SamanthaTriana/DERMATEC_tg/Anexo F_diseño_housing/Anexo F_ Housing_del_sistema_embebido.pdf

Anexo F: Housing del sistema embebido

Las tres versiones se desarrollaron progresivamente, incorporando

retroalimentación de pruebas funcionales y consideraciones de manufactura:

- Versión 1: Diseño inicial con geometría simple, enfoque en contención básica

de componentes.

Figura 1.

Ensamble del housing de la primera versión e impresión 3D del prototipo.

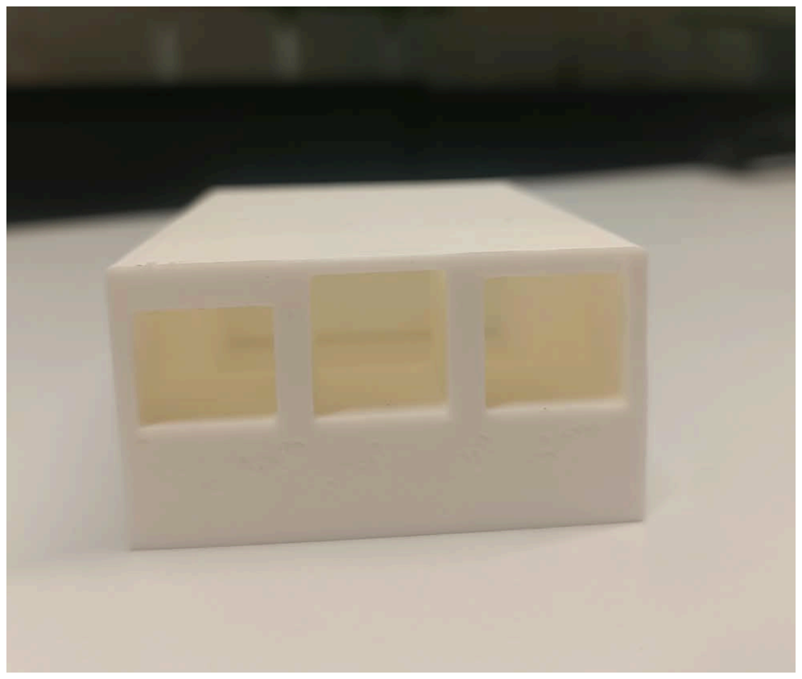
[picture p1: figure]
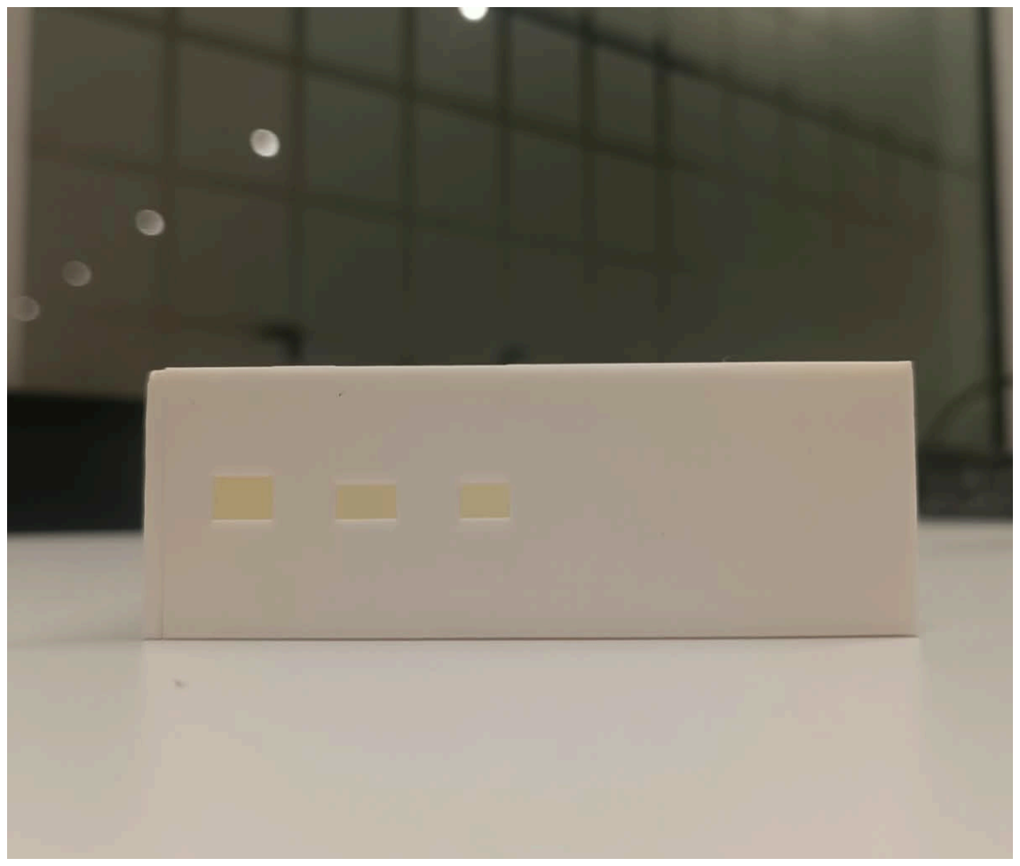
[picture p2: figure]
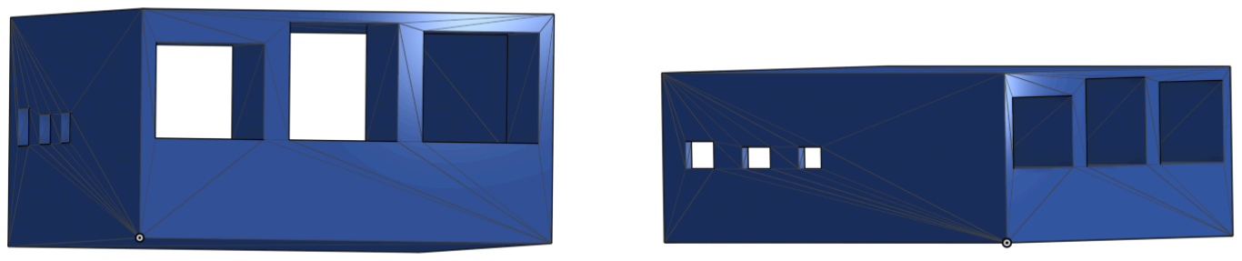
[picture p3: figure]

Nota: Ensamble de la primera versión. Creado por autores.

- Versión 2: Incorporación de mejoras térmicas, refinamiento de tolerancias y

acceso mejorado a puertos.

Figura 2.

Ensamble del housing de la segunda versión e impresión 3D del prototipo.

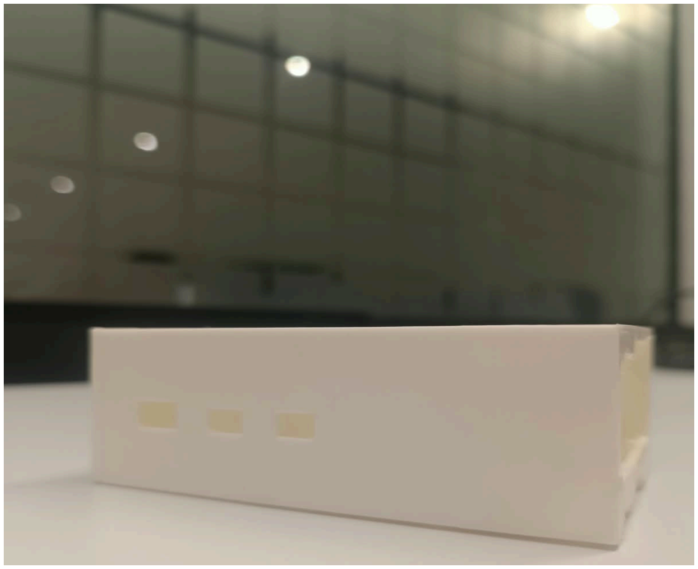
[picture p4: figure]
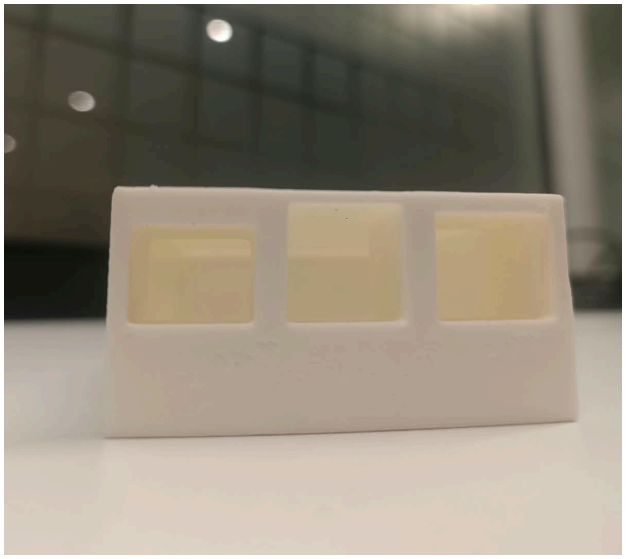
[picture p5: figure]
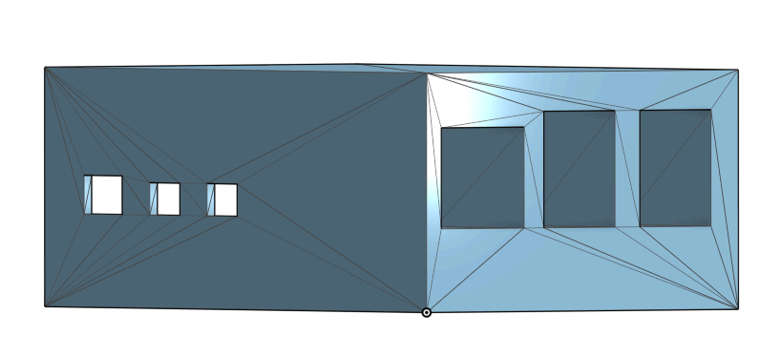
[picture p6: figure]
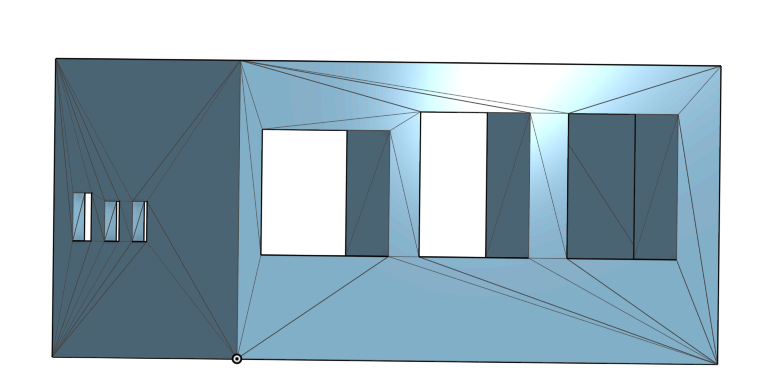
[picture p7: figure]

Nota: Ensamble de la segunda versión. Creado por autores.

- Versión 3 (Versión Final): Optimización completa con apertura de

ventilación, organización interna optimizada y montaje robusto.

Figura 3.

Ensamble del housing de la tercera versión e impresión 3D del prototipo.

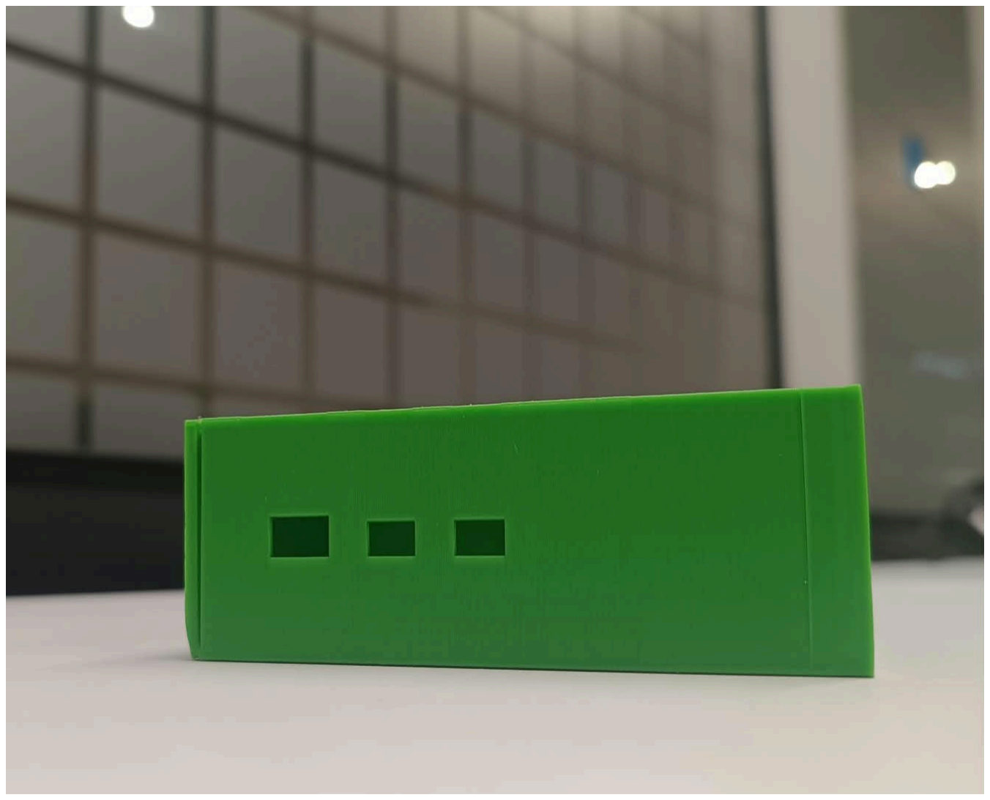
[picture p8: figure]
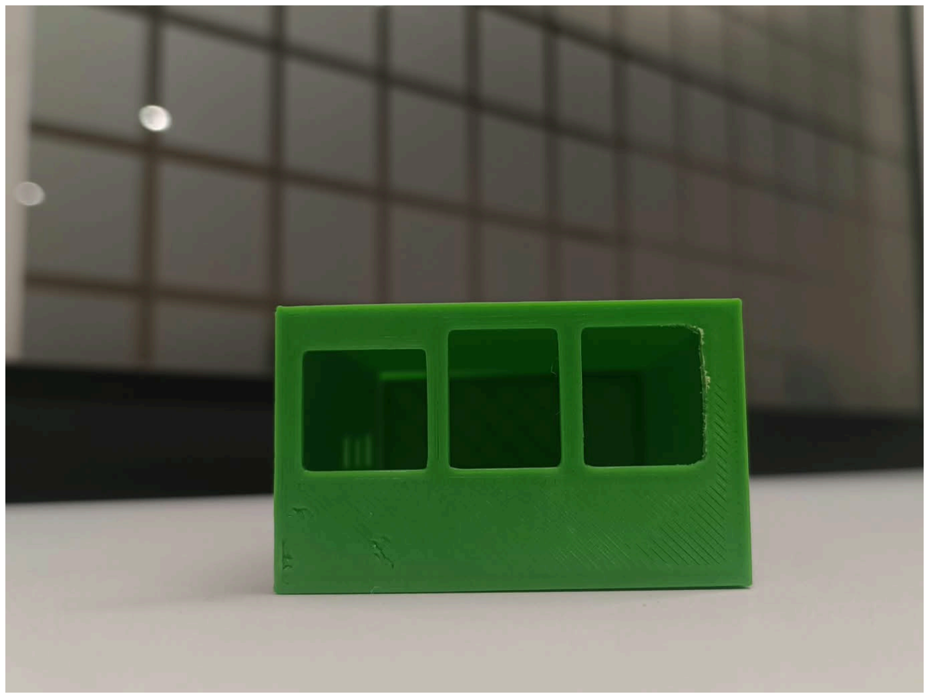
[picture p9: figure]
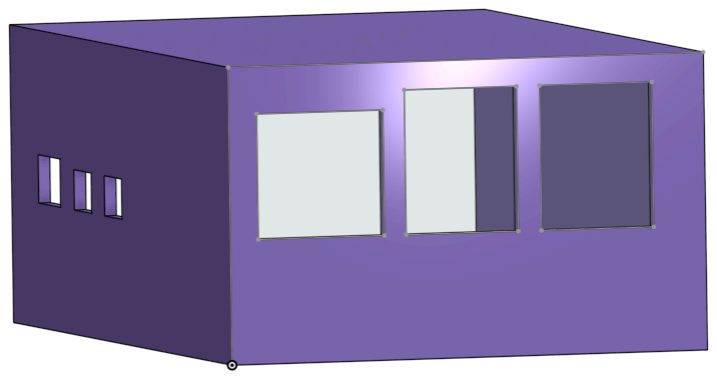
[picture p10: figure]
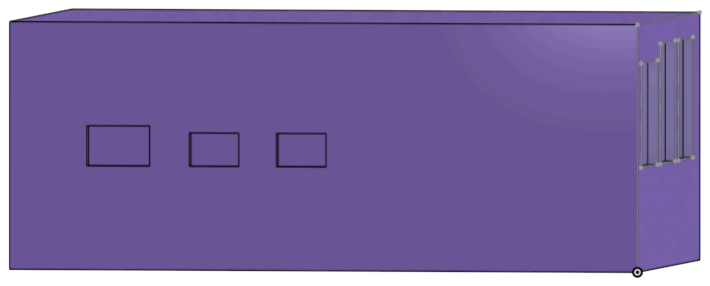
[picture p11: figure]

Nota: Ensamble de la tercera versión. Creado por autores.

Tabla 1.

Comparación de las tres versiones del housing del sistema embebido

Archivo | Versión | Descripción | Peso (g) | Tiempo de impresión
Versión1_Ho using_Sistem a_embebido (https://drive.google.com/drive/folders/13bw-nK-qMTHa4lXov2uEFAcAm-423_4d?usp=sharing) | Versión 1 | Housing inicial con acceso limitado a puertos | 32.28 g | 58.23 min
Versión2_Ho using_Sistem a_embebido (https://drive.google.com/drive/folders/1Rc3OV1-moV8CKS0pdN_POwuth0yu5dbW?usp=sharing) | Versión 2 | Housing mejorado con acceso | 32.05 g | 58.59 min

| | optimizado
Versión3_Ho using_Sistem a_embebido (https://drive.google.com/drive/folders/1wg97ZBLCk2QDdu6GiWOOChp3vurnwqcM?usp=sharing) | Versión 3 | Housing final con acceso completo a puertos | 31.82 g | 60 min

Nota.Evolución de las versiones del housing del sistema embebido. Creado por autores.
