SamanthaTriana/DERMATEC_tg/05_raspberry_pi/GUIA DERMATEC CORTA.pdf

## DERMATEC – Guía rápida (Windows 10/11)

Instalación (una sola vez, 10–15 minutos, con internet)

1. Descomprima el archivo DERMATEC_APP.zip (clic derecho → Extraer todo).
2. Abra la carpeta DERMATEC_APP y haga doble clic en DERMATEC.bat.
3. Se abrirá una ventana negra que instalará todo automáticamente. No la cierre.
4. Al terminar, se crea el ícono DERMATEC en el escritorio y se abre la aplicación.

Si Windows muestra "Windows protegió su PC", pulse "Más información" y luego "Ejecutar de todas formas".

Uso

1. Abra DERMATEC desde el ícono del escritorio.

Dos opciones de trabajo:

2. MENÚ → Nuevo paciente → Nueva lesión.
3. MENÚ → Cargar imágenes: seleccione una o varias fotos de la misma lesión tomadas con su dermatoscopio.
4. Pulse ANALIZAR LESIÓN.
