SamanthaTriana/DERMATEC_tg/03_modelos/Candidato_final/MATRICES_confusion_final.png

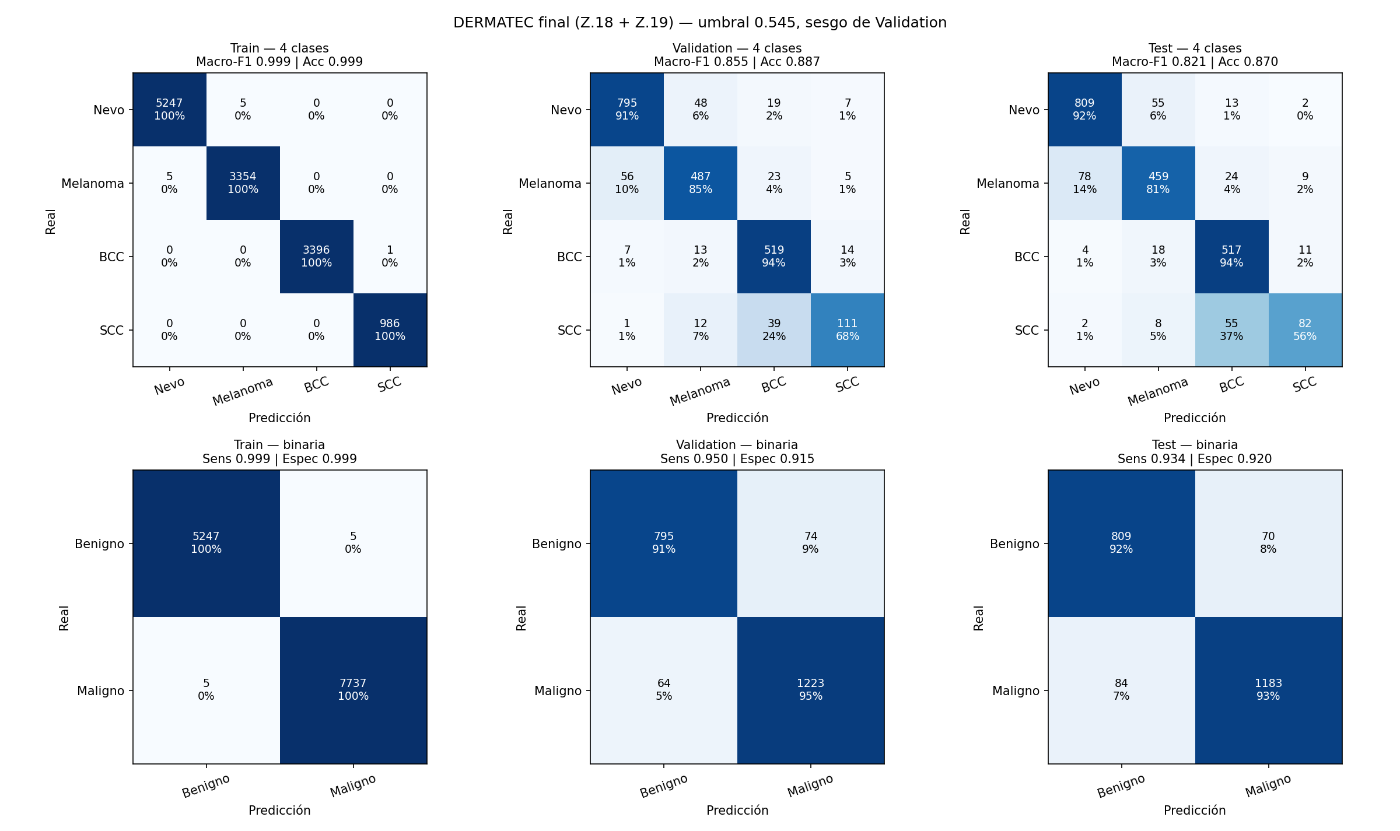
03_modelos/Candidato_final/MATRICES_confusion_final.png
