SamanthaTriana/DERMATEC_tg/Anexo C_sistemas_embebidos/tabla_comparativa_sistemas_embebidos.xlsx

Sistema Embebido | Referencia Comercial | RAM | Procesador | Frecuencia | Cámara | Conectividad | Interfaces Comunicación y Captura | Almacenamiento | Voltaje Alimentación | Pines GPIO | Puertos USB | Puertos Video | Sistema Operativo | Entorno Desarrollo | Compatibilidad Software | Velocidad Datos | Relación Costo-Beneficio | Disponibilidad
Raspberry Pi 5 | Raspberry Pi 5 (4/8/16GB) | 4GB/8GB/16GB LPDDR4X | Broadcom BCM2712 - Quad-core Cortex-A76 | 2.4 GHz | 2 conectores MIPI | Wi-Fi 802.11ac/5GHz + Bluetooth 5.0 + Gigabit Ethernet | 2 USB 3.0 + 2 USB 2.0; 2 conectores MIPI CSI/DSI | microSD | USB-C 5V/5A | 40 | 2 USB 3.0 + 2 USB 2.0 | 2 micro-HDMI 4Kp60 | Raspberry Pi OS | Python + Linux | OpenCV + TensorFlow Lite + TensorFlow | 2.4/5 GHz Wi-Fi | Excelente para aplicaciones de IA | $536.000 COP (4GB)
Raspberry Pi 4 Model B | Raspberry Pi 4B (1/2/4/8GB) | 1GB/2GB/4GB/8GB LPDDR4 | Broadcom BCM2711 - Quad-core Cortex-A72 | 1.8 GHz | 1 CSI + 1 DSI | Wi-Fi 2.4/5 GHz 802.11ac + Bluetooth 5.0 + Gigabit Ethernet | 2 USB 3.0 + 2 USB 2.0; CSI + DSI | microSD | USB-C 5V/3A | 40 | 2 USB 3.0 + 2 USB 2.0 | 2 micro-HDMI 4Kp60 | Raspberry Pi OS | Python + Linux | OpenCV + TensorFlow Lite + TensorFlow | 2.4/5 GHz Wi-Fi | Muy buena relación costo-beneficio | $439.000 COP (4GB)
Raspberry Pi 3 Model B+ | Raspberry Pi 3B+ | 1 GB LPDDR2 | Broadcom BCM2837B0 - Quad-core Cortex-A53 | 1.4 GHz | 1 CSI + 1 DSI | Wi-Fi 2.4/5 GHz 802.11ac + Bluetooth 4.2 + Gigabit Ethernet | 4 USB 2.0; CSI + DSI | microSD | micro-USB 5V/2.5A | 40 | 4 USB 2.0 | 1 HDMI | Raspberry Pi OS | Python + Linux | OpenCV + TensorFlow Lite | 2.4/5 GHz Wi-Fi | Buena opción económica (limitada) | $159.000-$353.000 COP (usado/nuevo)
Raspberry Pi Zero 2 W | Raspberry Pi Zero 2 W | 512 MB LPDDR2 | Broadcom BCM2710A1 - Quad-core Cortex-A53 | 1 GHz | CSI-2 | Wi-Fi 2.4 GHz 802.11 b/g/n + Bluetooth 4.2 | 1 USB 2.0 OTG; CSI-2 | microSD | micro-USB 5V/2.5A | 40 (sin soldar) | 1 USB 2.0 OTG | mini HDMI | Raspberry Pi OS | Python + Linux | OpenCV (limitado) + TensorFlow Lite | 2.4 GHz Wi-Fi | Limitada para IA compleja | $80.000-$150.000 COP (aproximado)
Raspberry Pi Pico 2 W | Raspberry Pi Pico 2 W | 520 KB SRAM | RP2350 - Dual Cortex-M33 / Hazard3 RISC-V | 150 MHz | No integrada | Wi-Fi 2.4 GHz 802.11n + Bluetooth 5.2 | 2 UART + 2 SPI + 2 I2C + PWM + ADC | Flash 4 MB | USB o 1.8-5.5V | 26 | 1 USB (programación) | --- | Bare Metal + C/C++/MicroPython | MicroPython + CircuitPython | Sin OpenCV ni TensorFlow nativo | 2.4 GHz Wi-Fi | No recomendada como cerebro principal | $40.000-$60.000 COP (aproximado)
Arduino UNO R4 WiFi | Arduino UNO R4 WiFi | 32 kB SRAM | Renesas RA4M1 - Cortex-M4 | 48 MHz | No integrada | Wi-Fi + Bluetooth (ESP32-S3 integrado) | USB-C; módulo WiFi | No incluida | USB-C o VIN 6-24V | 14 digitales + 6 analógicos | 1 USB-C | --- | Arduino IDE | Arduino IDE + C/C++ | Sin OpenCV ni TensorFlow Lite | Wi-Fi/Bluetooth | Bajo para aplicaciones de IA | $150.000-$200.000 COP (aproximado)
Arduino Mega 2560 Rev3 | Arduino Mega 2560 | 8 KB SRAM | ATmega2560 - Atmega | 16 MHz | No integrada | No integrada | 4 UART + SPI + I2C | 256 KB Flash | USB o Jack DC 7-12V | 54 digitales | 1 USB | --- | Arduino IDE | Arduino IDE + C/C++ | Sin OpenCV ni TensorFlow | Comunicación limitada | Muy limitada para IA | $100.000-$150.000 COP (aproximado)
Arduino Nano ESP32 | Arduino Nano ESP32 | 8 MB RAM | u-blox NORA-W106 (ESP32-S3) - Xtensa LX7 | 240 MHz | No integrada | Wi-Fi + Bluetooth LE | 2 UART + I2C + SPI; puerto USB-C | 16 MB Flash externa + 8 MB RAM | 6-21V | 14 digitales + 8 analógicos | 1 USB-C | --- | Arduino IDE | Arduino IDE + MicroPython | MicroPython + TensorFlow Lite Micro | Wi-Fi + Bluetooth | Moderada (requiere adaptación) | $165.000 COP
Arduino GIGA R1 WiFi | Arduino GIGA R1 WiFi | 8 MB SDRAM | STM32H747XI - Dual-core (Cortex-M7 480 MHz + Cortex-M4 240 MHz) | 480/240 MHz | Conectores dedicados | Wi-Fi + Bluetooth | USB-C + USB-A host; CSI + DSI | 16 MB flash externa | 6-24V | 76 digitales | 1 USB-C + 1 USB-A host | --- | Arduino IDE + STM32CubeMX | Arduino IDE + C/C++ + TensorFlow Lite | TensorFlow Lite + OpenCV (parcial) | Wi-Fi + Bluetooth | Buena para aplicaciones de visión | $250.000-$350.000 COP (aproximado)
Arduino Portenta H7 | Arduino Portenta H7 | 1 MB RAM | STM32H747XI - Dual-core (Cortex-M7 480 MHz + Cortex-M4 240 MHz) | 480/240 MHz | Conector de cámara | Wi-Fi/Bluetooth/Ethernet PHY/USB HS | Conector 80 pines densidad | 16 MB NOR Flash + 8 MB SDRAM | --- | Conector de alta densidad | 1 USB-C | --- | Arduino IDE + STM32CubeMX | Arduino IDE + TensorFlow Lite + OpenCV | TensorFlow Lite + OpenCV | Wi-Fi + Bluetooth + Ethernet | Excelente para IA y visión | $400.000-$500.000 COP (aproximado)
ESP32-DevKitC V4 | ESP32-DevKitC V4 | N/A (externa) | ESP32-WROOM-32 - Dual-core Xtensa LX6 | 240 MHz | No integrada | Wi-Fi 2.4 GHz 802.11 b/g/n + Bluetooth 4.2 | SPI + I2C + I2S + UART + ADC + DAC + Touch | N/A (externa) | micro-USB 5V | Mayoría expuesta (~32 GPIO) | 1 micro-USB | --- | Arduino IDE + ESP-IDF | Arduino IDE + MicroPython + TensorFlow Lite Micro | TensorFlow Lite Micro + MicroPython | 2.4 GHz Wi-Fi | Buena relación costo-beneficio | $50.000-$80.000 COP (aproximado)
ESP32-S3-DevKitC-1 | ESP32-S3-DevKitC-1 | N/A (externa) | ESP32-S3 - Dual-core Xtensa LX7 | 240 MHz | No integrada | Wi-Fi 2.4 GHz 802.11 b/g/n + Bluetooth 5 LE | SPI + UART + I2C + I2S + USB-OTG + ADC + Touch | Soporta PSRAM | USB 5V | 45 GPIO | 1 USB | --- | Arduino IDE + ESP-IDF | Arduino IDE + MicroPython + TensorFlow Lite Micro | TensorFlow Lite Micro + MicroPython | 2.4 GHz Wi-Fi | Buena para AIoT | $60.000-$100.000 COP (aproximado)
ESP32-S3-EYE | ESP32-S3-EYE | 8 MB PSRAM | ESP32-S3 - Dual-core Xtensa LX7 | 240 MHz | 2 MP integrada | Wi-Fi 2.4 GHz | Micro-USB; cámara integrada | 8 MB Flash | Micro-USB 5V | N/A (integrada) | 1 Micro-USB | --- | Arduino IDE + ESP-IDF | Arduino IDE + MicroPython + TensorFlow Lite Micro | TensorFlow Lite Micro + Visión embebida | 2.4 GHz Wi-Fi | Excelente para reconocimiento de imágenes/voz | $120.000-$180.000 COP (aproximado)
