SamanthaTriana/DERMATEC_tg/Anexo D_acople_mecanico/soportelente_p1.stl

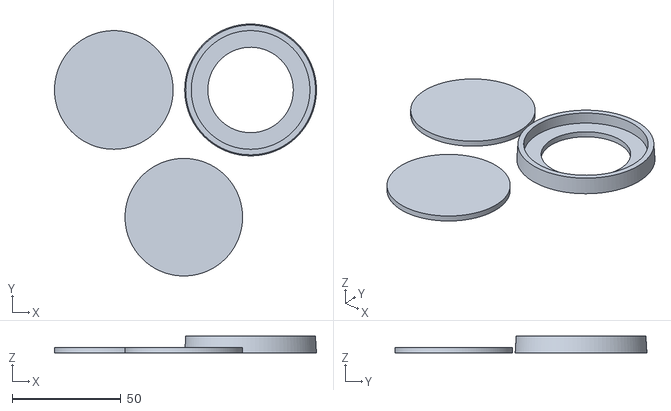
[picture p56: CAD file, 2026-10-11]
Anexo D_acople_mecanico/soportelente_p1.stl
120.3 x 115.7 x 7.62
