SamanthaTriana/DERMATEC_tg/Anexo F_diseño_housing/Versión1_Housing_Sistema_embebido/Caja.stl

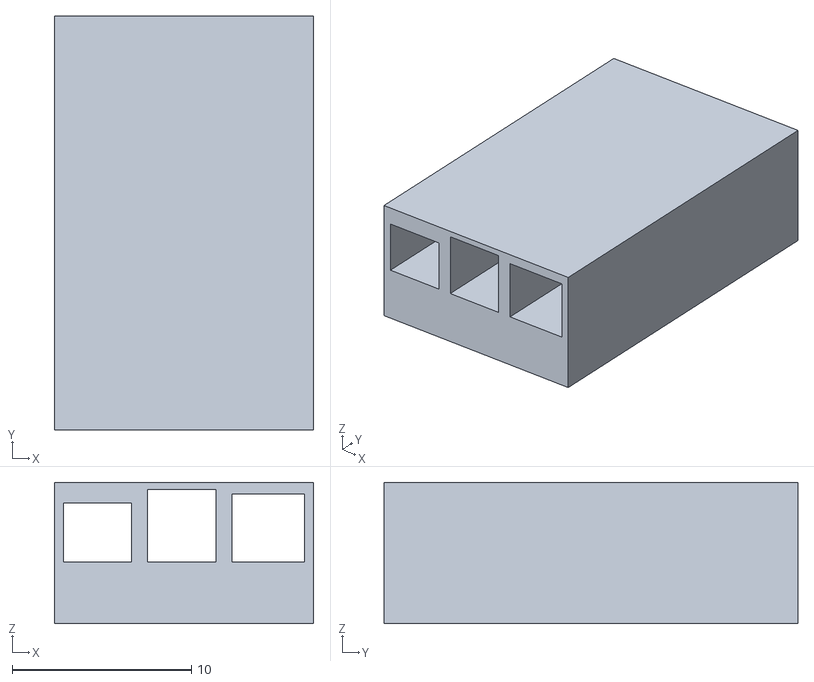
[picture p57: CAD file, 2026-10-11]
Anexo F_diseño_housing/Versión1_Housing_Sistema_embebido/Caja.stl
14.5 x 23.1 x 7.87
