SamanthaTriana/DERMATEC_tg/Anexo F_diseño_housing/Versión2_Housing_Sistema_embebido/Caja_v2.stl

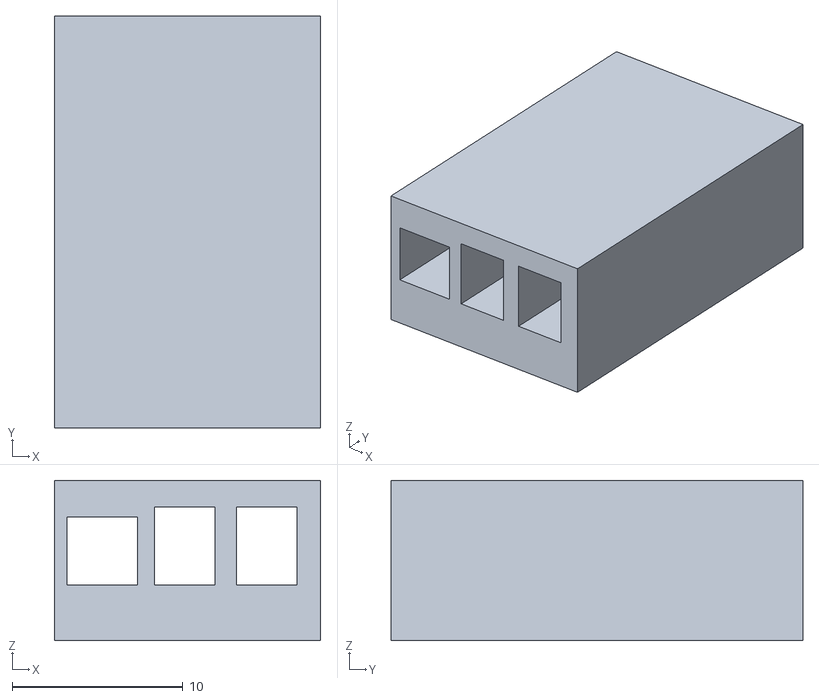
[picture p58: CAD file, 2026-10-11]
Anexo F_diseño_housing/Versión2_Housing_Sistema_embebido/Caja_v2.stl
15.6 x 24.1 x 9.40
