SamanthaTriana/DERMATEC_tg/Anexo F_diseño_housing/Versión3_Housing_Sistema_embebido/Caja_vfinal.stl

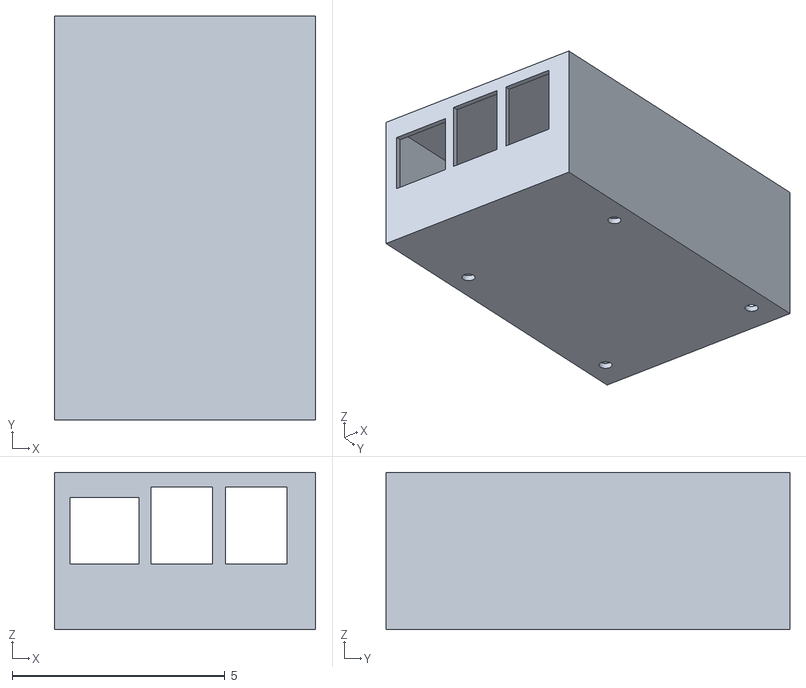
[picture p59: CAD file, 2026-10-11]
Anexo F_diseño_housing/Versión3_Housing_Sistema_embebido/Caja_vfinal.stl
6.14 x 9.50 x 3.70
