SamanthaTriana/DERMATEC_tg/Anexo D_acople_mecanico/soportelente_p5.stl

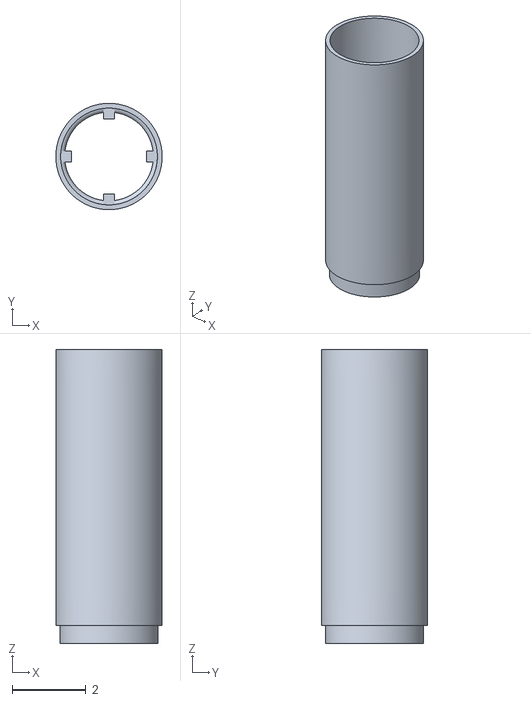
[picture p60: CAD file, 2026-10-11]
Anexo D_acople_mecanico/soportelente_p5.stl
2.89 x 2.89 x 8.00
