SamanthaTriana/DERMATEC_tg/Anexo F_diseño_housing/Versión1_Housing_Sistema_embebido/Tapa de caja.stl

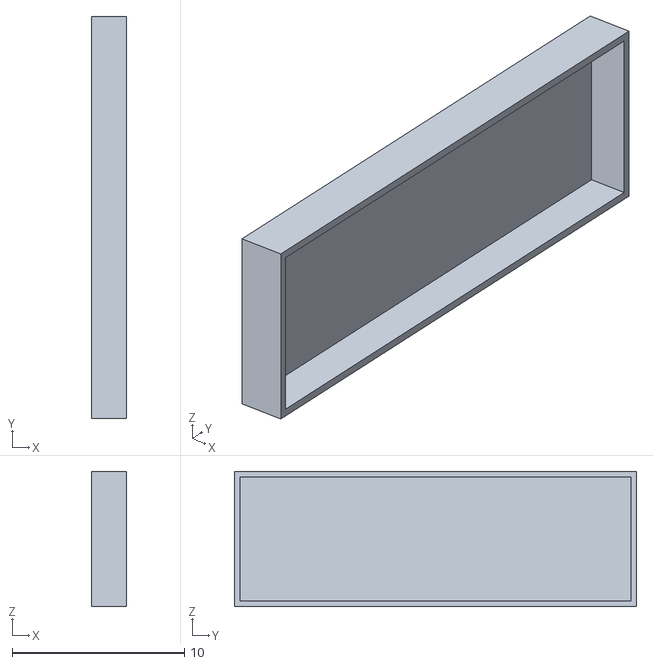
[picture p61: CAD file, 2026-10-11]
Anexo F_diseño_housing/Versión1_Housing_Sistema_embebido/Tapa de caja.stl
2.03 x 23.4 x 7.87
