SamanthaTriana/DERMATEC_tg/Anexo F_diseño_housing/Versión2_Housing_Sistema_embebido/Tapa de caja_v2.stl

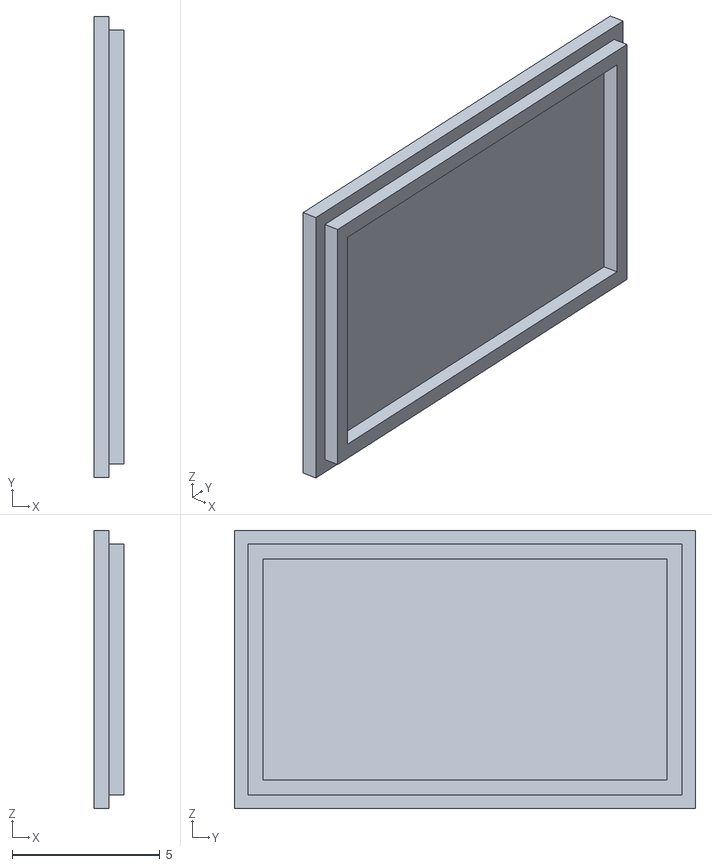
[picture p62: CAD file, 2026-10-11]
Anexo F_diseño_housing/Versión2_Housing_Sistema_embebido/Tapa de caja_v2.stl
1.02 x 15.6 x 9.40
