SamanthaTriana/DERMATEC_tg/Anexo F_diseño_housing/Versión3_Housing_Sistema_embebido/Tapa de caja_vfinal.stl

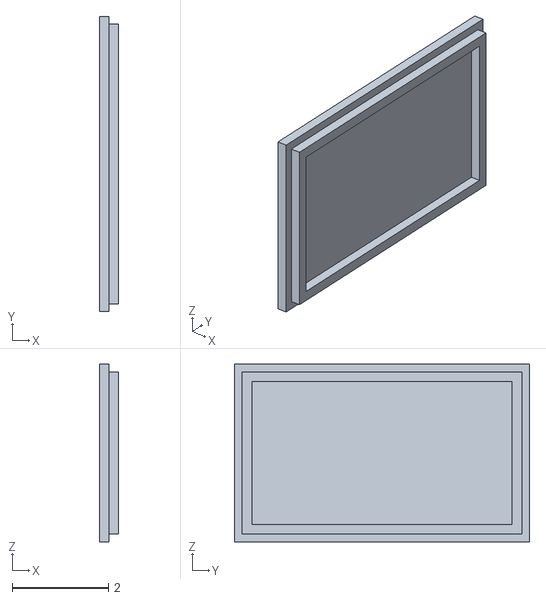
[picture p63: CAD file, 2026-10-11]
Anexo F_diseño_housing/Versión3_Housing_Sistema_embebido/Tapa de caja_vfinal.stl
0.4 x 6.14 x 3.70
