SamanthaTriana/DERMATEC_tg/Anexo D_acople_mecanico/soportelente_p4.stl

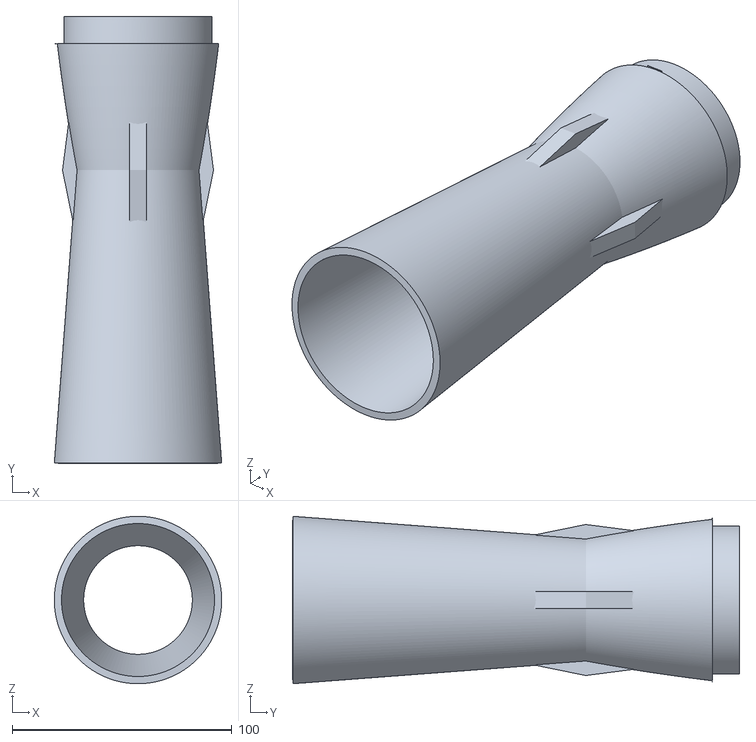
[picture p64: CAD file, 2026-10-11]
Anexo D_acople_mecanico/soportelente_p4.stl
76.2 x 203.4 x 76.2
