SamanthaTriana/DERMATEC_tg/Anexo D_acople_mecanico/soportelente_p2.stl

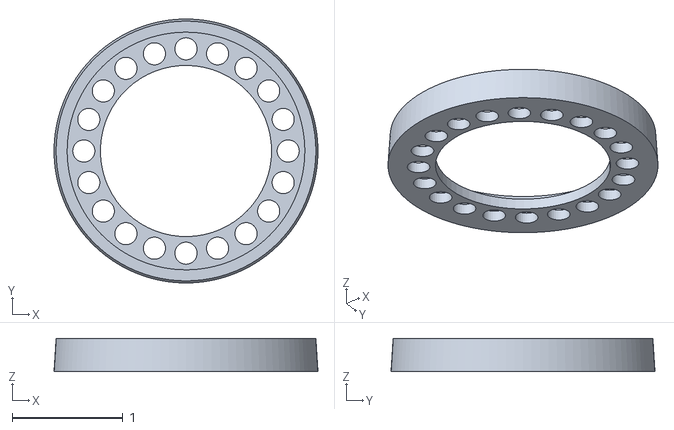
[picture p65: CAD file, 2026-10-11]
Anexo D_acople_mecanico/soportelente_p2.stl
2.38 x 2.38 x 0.3
