SamanthaTriana/DERMATEC_tg/Anexo D_acople_mecanico/soportelente_p3.stl

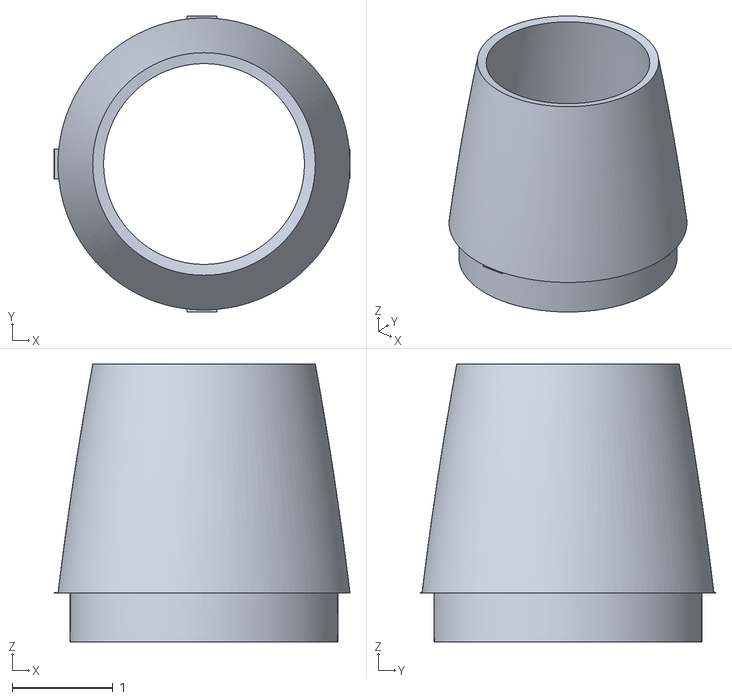
[picture p66: CAD file, 2026-10-11]
Anexo D_acople_mecanico/soportelente_p3.stl
2.93 x 2.93 x 2.75
