SamanthaTriana/DERMATEC_tg/Manual_DERMATEC_libro.pdf

# MANUAL DE USO

# DERMATEC

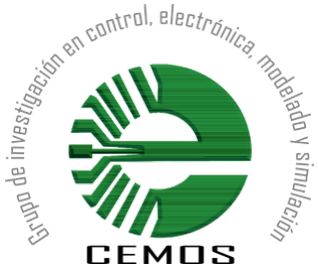
[picture p67: figure]
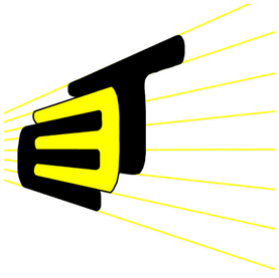
[picture p68: figure]
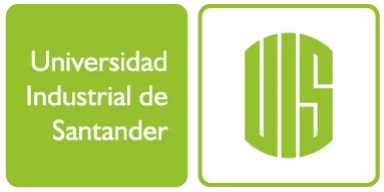
[picture p69: figure]
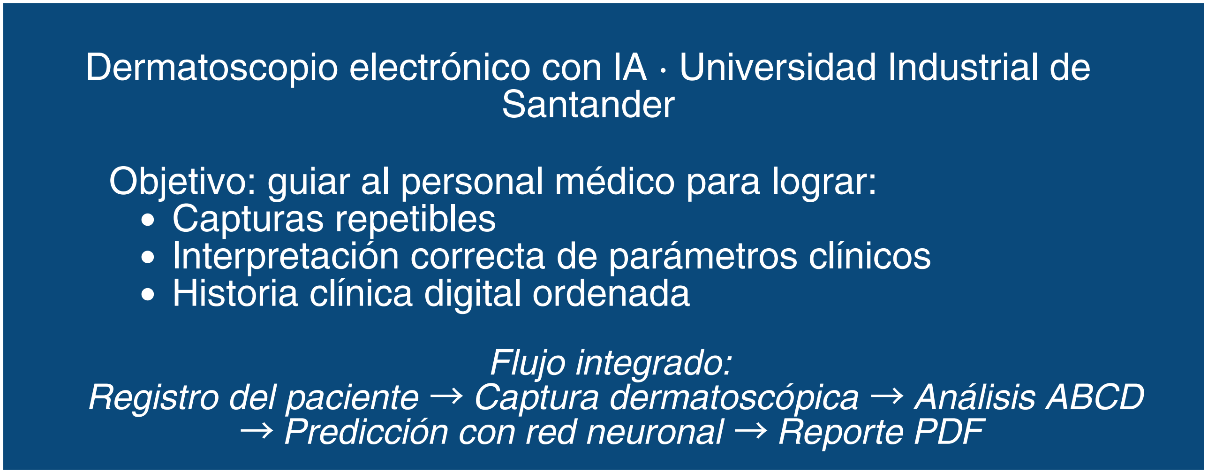
[picture p70: figure]
Santander; Capturas repetibles Interpretación correcta de parámetros clínicos Historia clínica digital ordenada; Flujo integrado:

Dermatoscopio electrónico con IA · Universidad Industrial de

Objetivo: guiar al personal médico para lograr:

Registro del paciente → Captura dermatoscópica → Análisis ABCD → Predicción con red neuronal → Reporte PDF

# ADVERTENCIAS

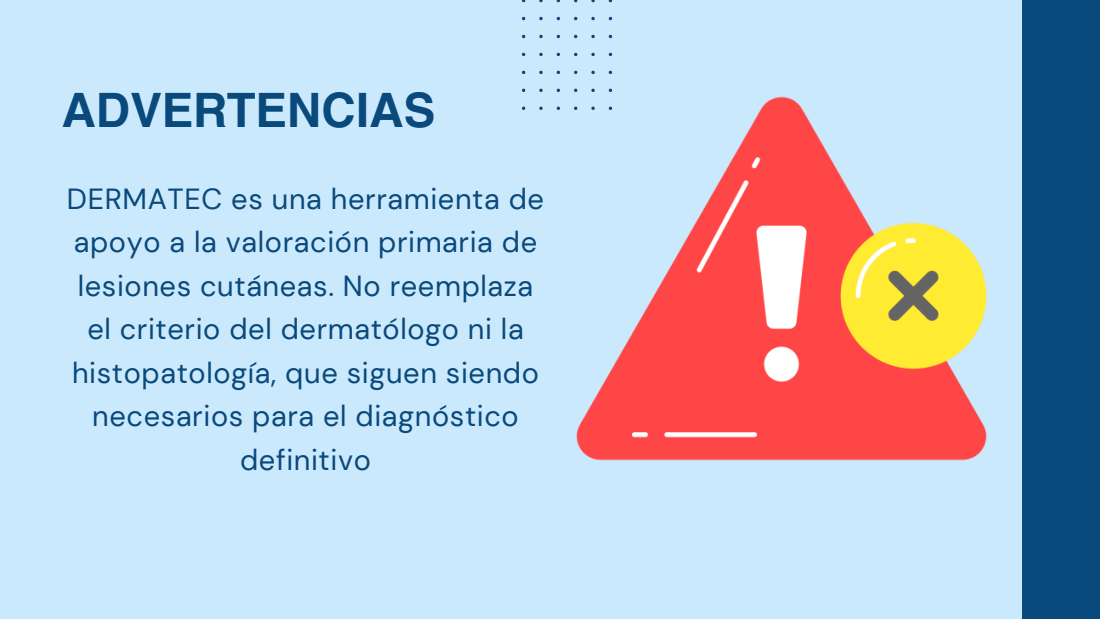
[picture p71: page 2]
definitivo

DERMATEC es una herramienta de
apoyo a la valoración primaria de
lesiones cutáneas. No reemplaza
el criterio del dermatólogo ni la
histopatología, que siguen siendo
necesarios para el diagnóstico

EL SISTEMA TRABAJA CON CUATRO CLASES DE LESIÓN:

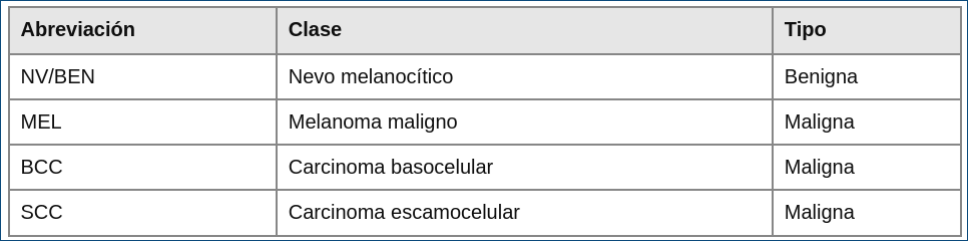
[picture p72: figure]

01 COMPONENTES DEL SISTEMA

Antes de iniciar, verifique que dispone de todos los elementos listados.

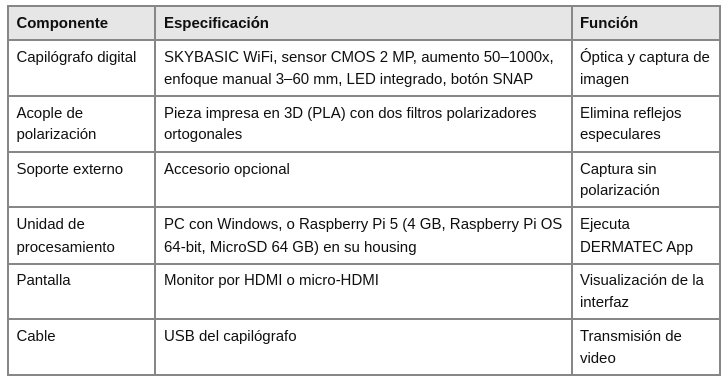
[picture p73: figure]

Software. DERMATEC App V6 desarrollada en Python con Tkinter. En Windows la captura usa DirectShow (pygrabber); en Linux, V4L2. La clasificación usa un ensamble de dos redes, EfficientNetV2-B0 y MobileNetV3-Large (Z.18 + Z.19), ejecutadas con LiteRT tanto en el PC como en la Raspberry Pi 5.

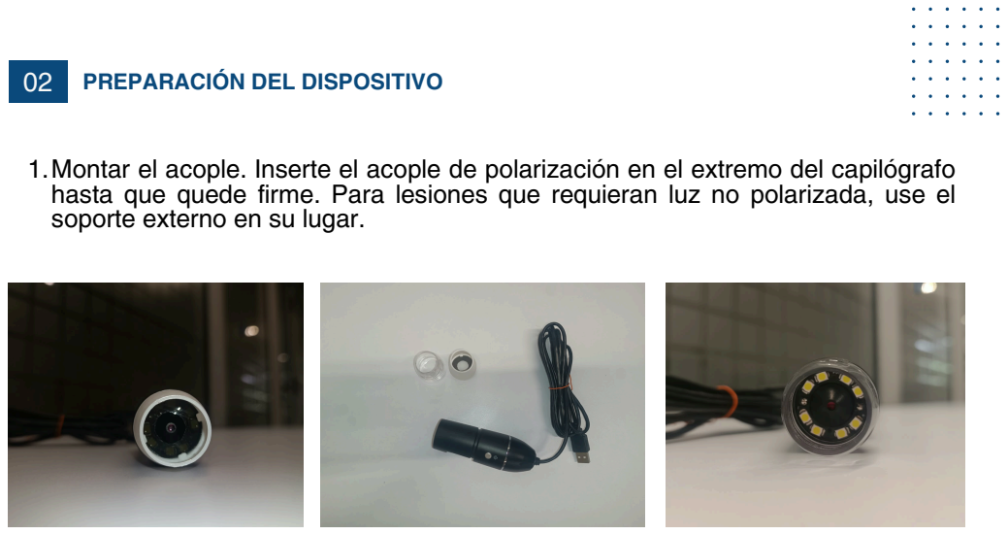
[picture p74: page 5]
PREPARACIÓN DEL DISPOSITIVO

1.Montar el acople. Inserte el acople de polarización en el extremo del capilógrafo
hasta que quede firme. Para lesiones que requieran luz no polarizada, use el
soporte externo en su lugar.

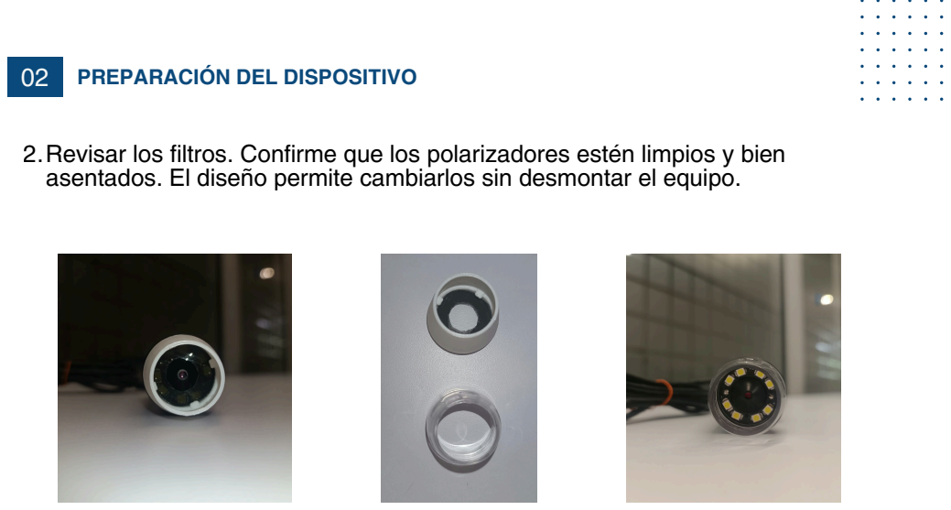
[picture p75: page 6]
PREPARACIÓN DEL DISPOSITIVO

2.Revisar los filtros. Confirme que los polarizadores estén limpios y bien
asentados. El diseño permite cambiarlos sin desmontar el equipo.

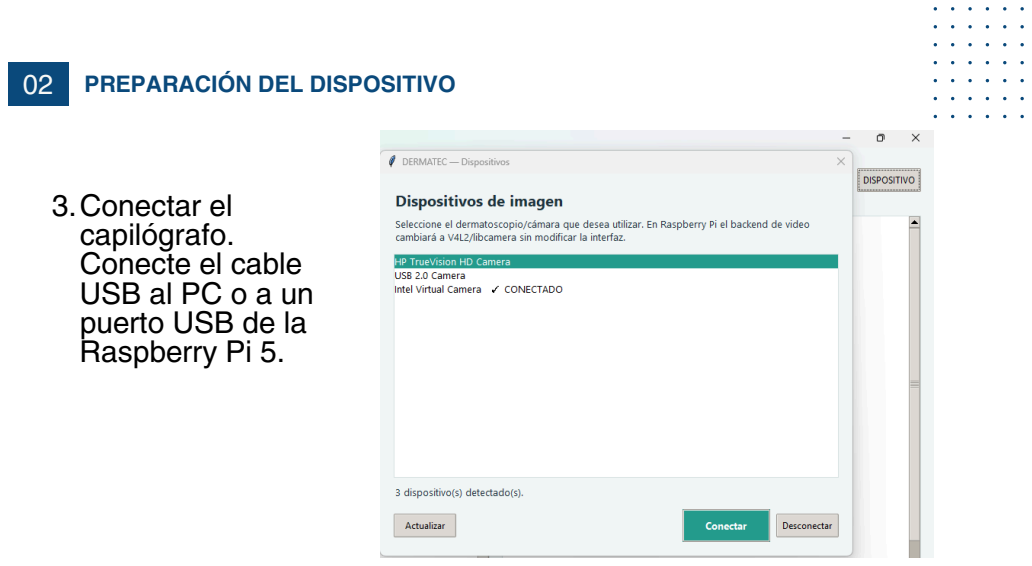
[picture p76: page 7]
PREPARACIÓN DEL DISPOSITIVO

3.Conectar el
capilógrafo.
Conecte el cable
USB al PC o a un
puerto USB de la
Raspberry Pi 5.

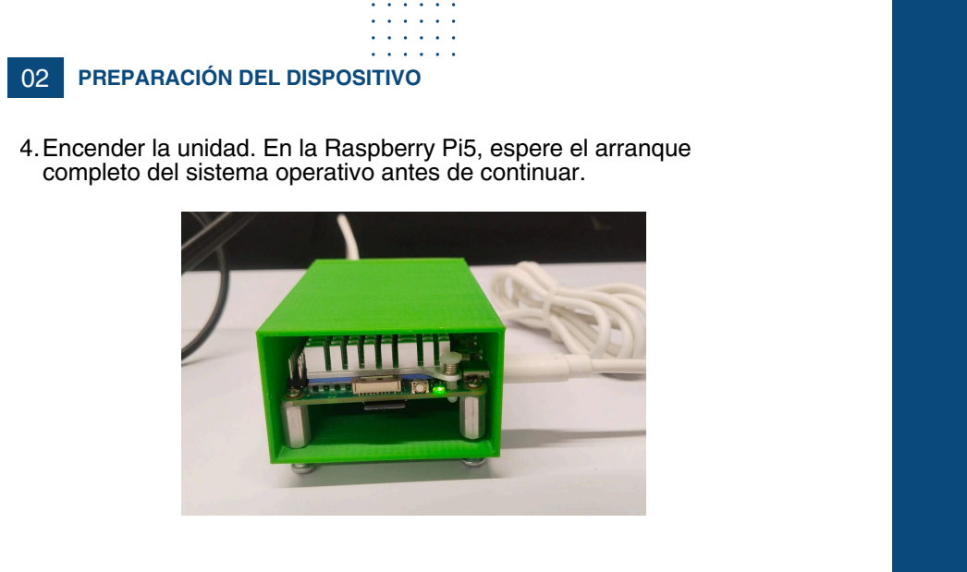
[picture p77: page 8]
PREPARACIÓN DEL DISPOSITIVO

4.Encender la unidad. En la Raspberry Pi5, espere el arranque
completo del sistema operativo antes de continuar.

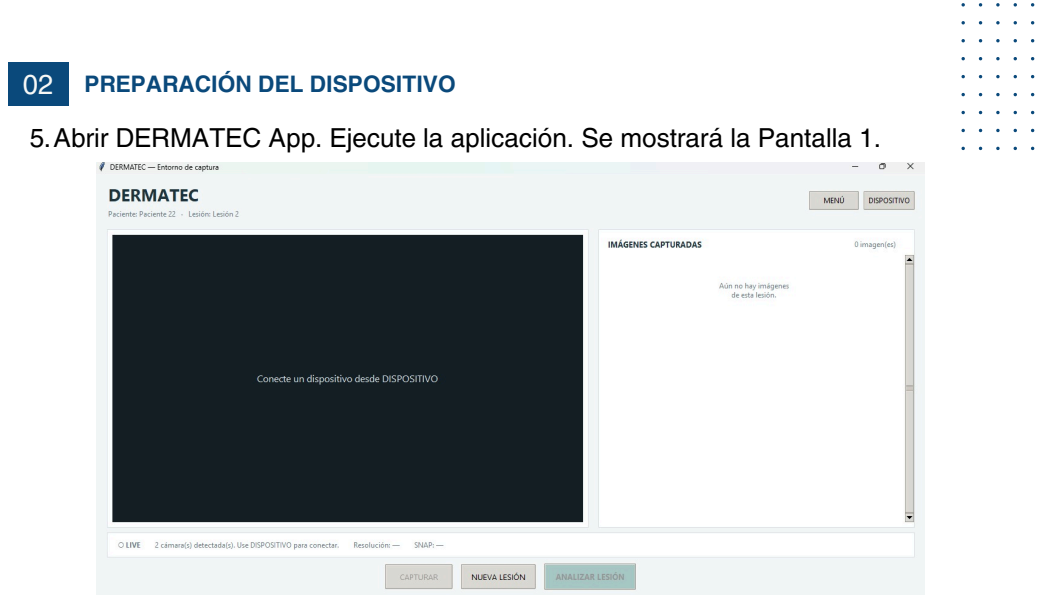
[picture p78: page 9]
PREPARACIÓN DEL DISPOSITIVO

5.Abrir DERMATEC App. Ejecute la aplicación. Se mostrará la Pantalla 1.

## Flu

j

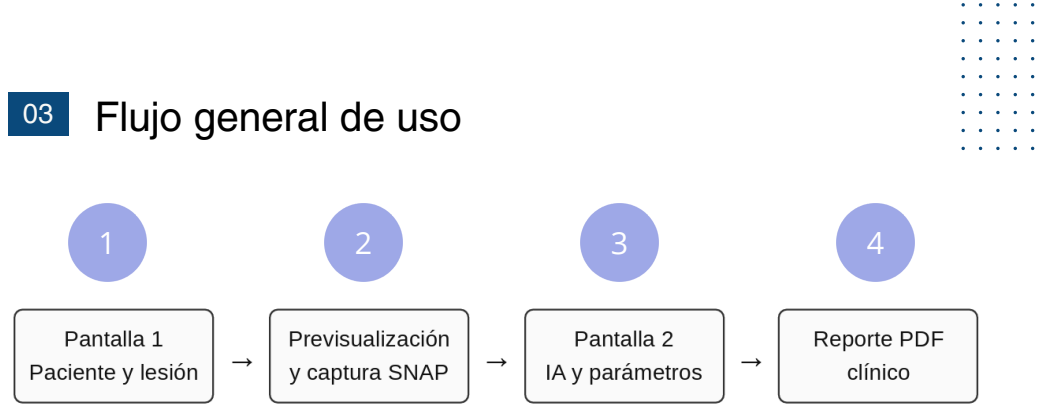
[picture p79: page 10]

1

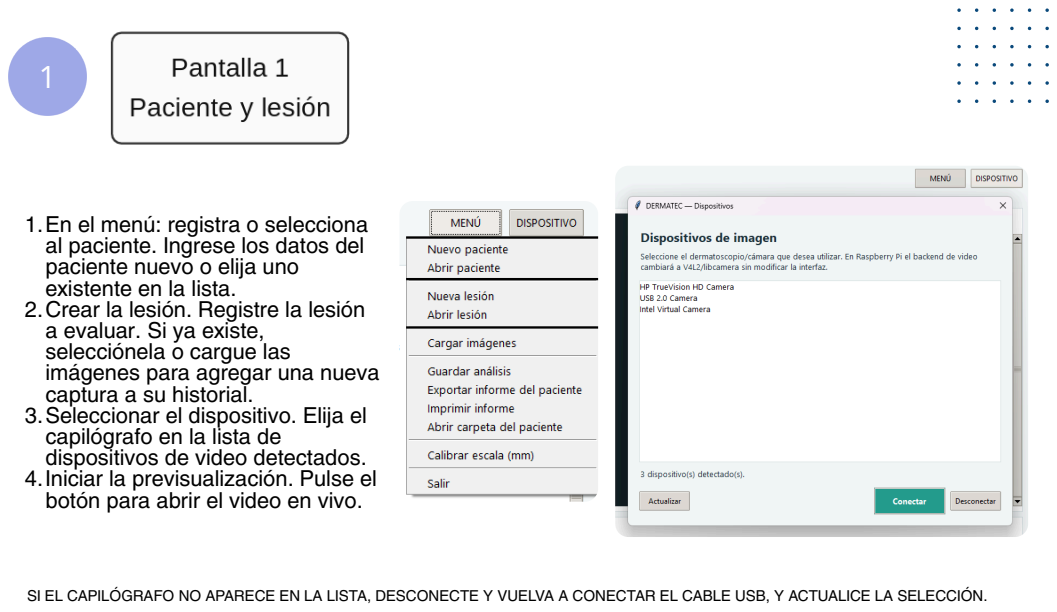
[picture p80: page 11]

1.En el menú: registra o selecciona
al paciente. Ingrese los datos del
paciente nuevo o elija uno
existente en la lista.
2.Crear la lesión. Registre la lesión
a evaluar. Si ya existe,
selecciónela o cargue las
imágenes para agregar una nueva
captura a su historial.
3.Seleccionar el dispositivo. Elija el
capilógrafo en la lista de
dispositivos de video detectados.
4.Iniciar la previsualización. Pulse el
botón para abrir el video en vivo.

SI EL CAPILÓGRAFO NO APARECE EN LA LISTA, DESCONECTE Y VUELVA A CONECTAR EL CABLE USB, Y ACTUALICE LA SELECCIÓN.

2

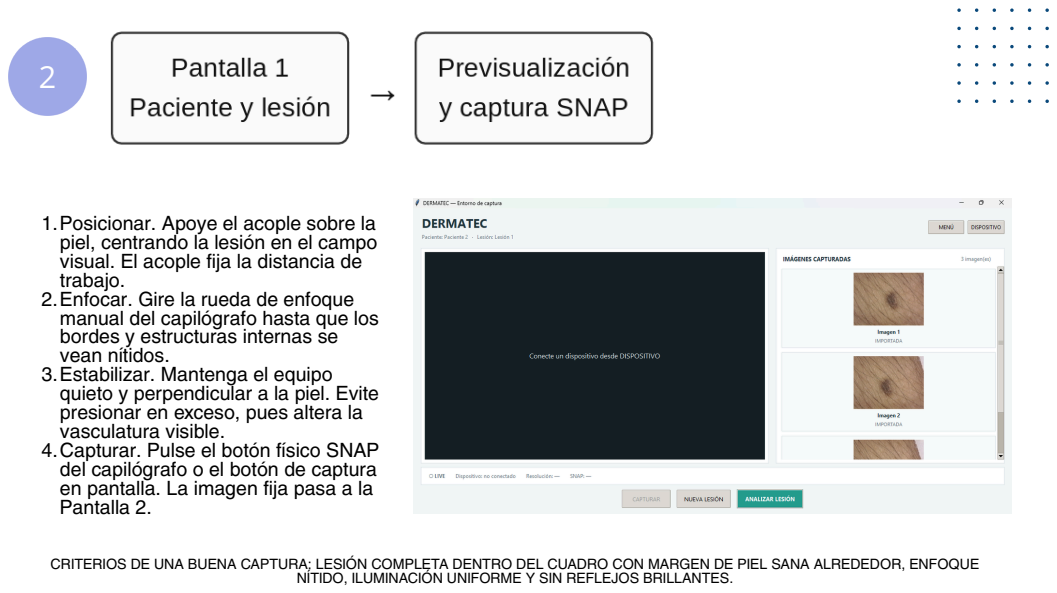
[picture p81: page 12]

1.Posicionar. Apoye el acople sobre la
piel, centrando la lesión en el campo
visual. El acople fija la distancia de
trabajo.
2.Enfocar. Gire la rueda de enfoque
manual del capilógrafo hasta que los
bordes y estructuras internas se
vean nítidos.
3.Estabilizar. Mantenga el equipo
quieto y perpendicular a la piel. Evite
presionar en exceso, pues altera la
vasculatura visible.
4.Capturar. Pulse el botón físico SNAP
del capilógrafo o el botón de captura
en pantalla. La imagen fija pasa a la
Pantalla 2.

CRITERIOS DE UNA BUENA CAPTURA: LESIÓN COMPLETA DENTRO DEL CUADRO CON MARGEN DE PIEL SANA ALREDEDOR, ENFOQUE

NÍTIDO, ILUMINACIÓN UNIFORME Y SIN REFLEJOS BRILLANTES.

3

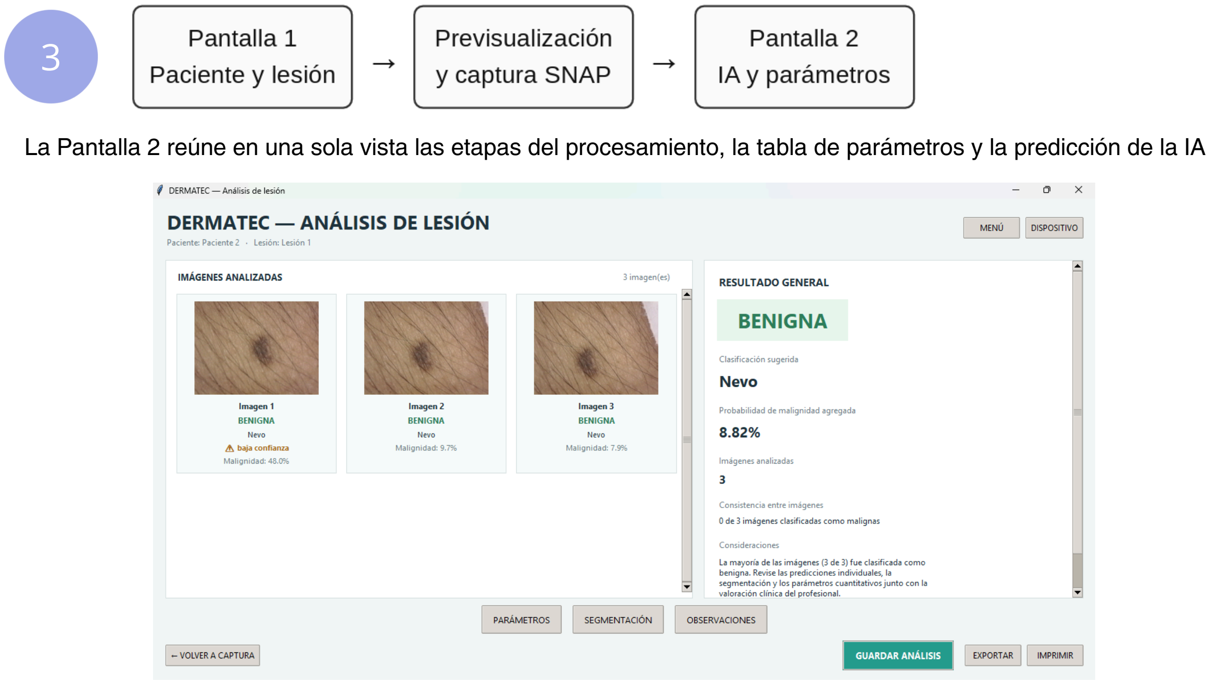
[picture p82: page 13]

La Pantalla 2 reúne en una sola vista las etapas del procesamiento, la tabla de parámetros y la predicción de la IA

3

### VERIFICACIÓN DE LA SEGMENTACIÓN (OBLIGATORIA)

### 1.Compare la máscara con la imagen original antes de interpretar

resultados.

### 2.Si el contorno incluye piel sana o sombras, o si deja fuera parte de la lesión, repita la captura, porque los parámetros de forma

dependen de ese contorno.

### 3.La imagen sin vello solo sirve para trazar la máscara. El color y la textura se calculan siempre sobre la imagen original, así que

el inpainting no los altera.

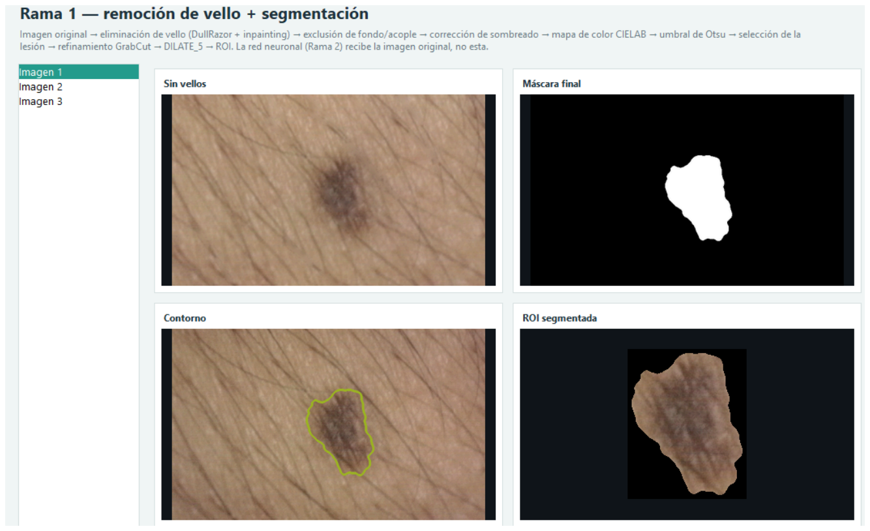
[picture p83: page 15]

## 04 Interpretación de los parámetros clínicos

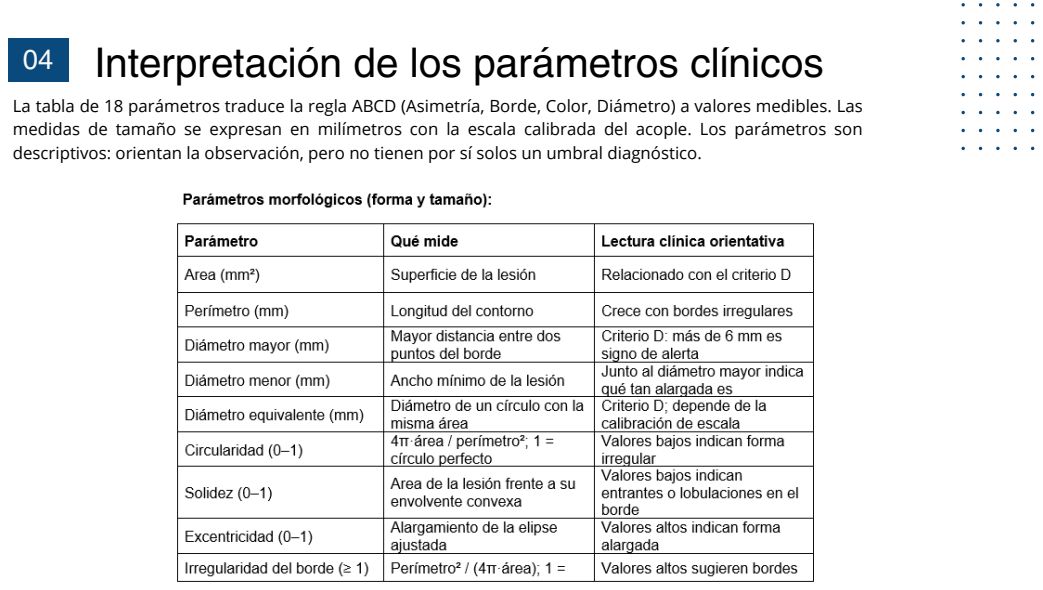
[picture p84: page 16]

La tabla de 18 parámetros traduce la regla ABCD (Asimetría, Borde, Color, Diámetro) a valores medibles. Las
medidas de tamaño se expresan en milímetros con la escala calibrada del acople. Los parámetros son
descriptivos: orientan la observación, pero no tienen por sí solos un umbral diagnóstico.

## 04 Interpretación de los parámetros clínicos

Parámetros de color (criterio C): Media, desviación estándar y entropía de cada canal en los espacios RGB, CIELab y HSV. Una desviación o entropía alta indica varios tonos dentro de la lesión; la policromía es un signo de alerta en dermatoscopia.

Parámetros | de | textura | (GLCM): | Contraste, | disimilitud,
homogeneidad, energía y correlación. Contraste y disimilitud altos indican una estructura interna heterogénea; homogeneidad y energía altas indican un patrón uniforme.

## 05 Interpretación de la predicción de la red

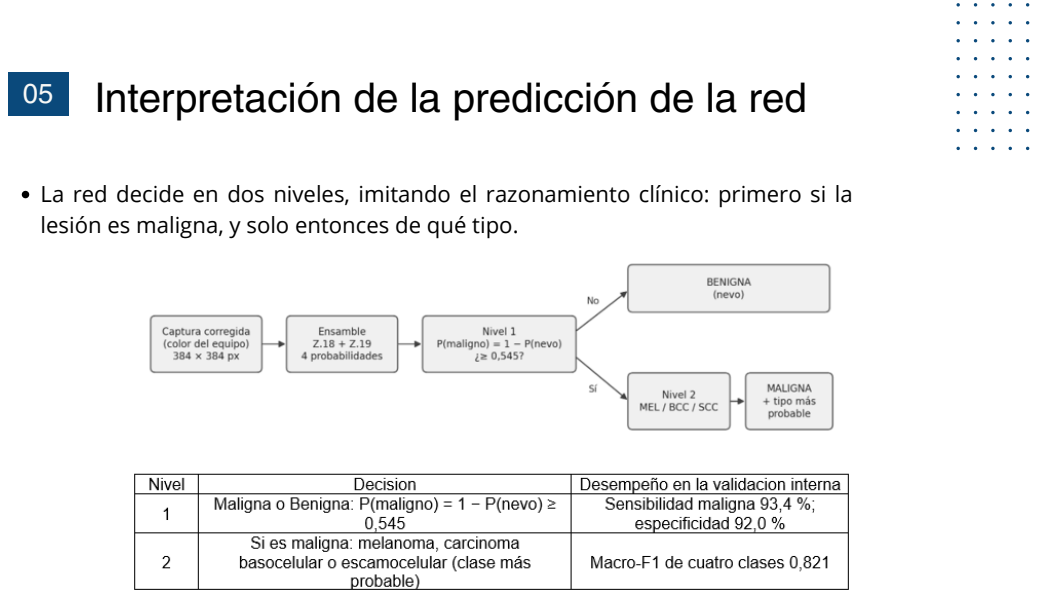
[picture p85: page 18]

La red decide en dos niveles, imitando el razonamiento clínico: primero si la
lesión es maligna, y solo entonces de qué tipo.

## 05 Interpretación de la predicción de la red

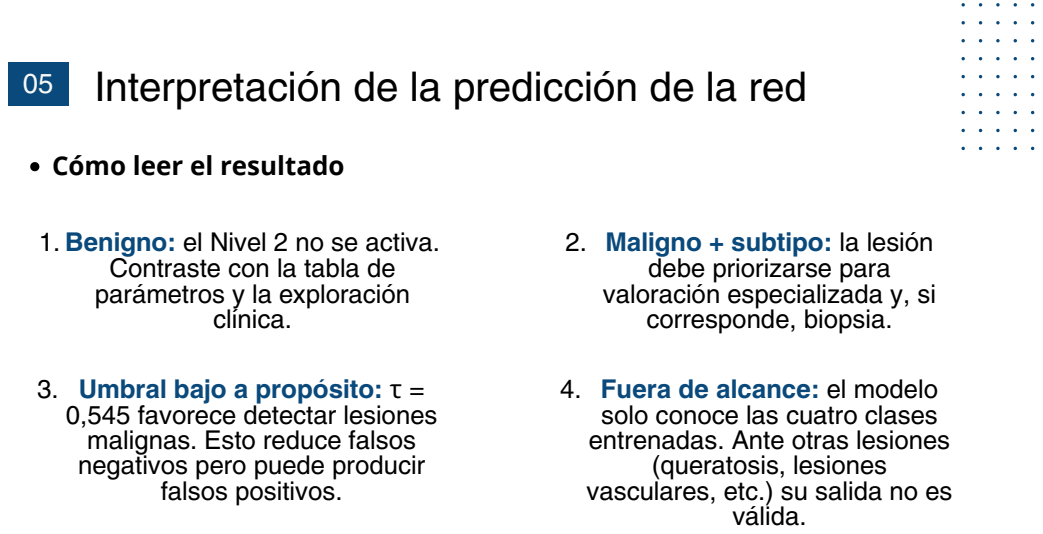
[picture p86: page 19]
clínica.; válida.

Cómo leer el resultado

1. Benigno: el Nivel 2 no se activa.
Contraste con la tabla de
parámetros y la exploración

2. Maligno + subtipo: la lesión
debe priorizarse para
valoración especializada y, si
corresponde, biopsia.

3. Umbral bajo a propósito: τ =
0,545 favorece detectar lesiones
malignas. Esto reduce falsos
negativos pero puede producir
falsos positivos.

4. Fuera de alcance: el modelo
solo conoce las cuatro clases
entrenadas. Ante otras lesiones
(queratosis, lesiones
vasculares, etc.) su salida no es

## 06 Reporte PDF y almacenamiento

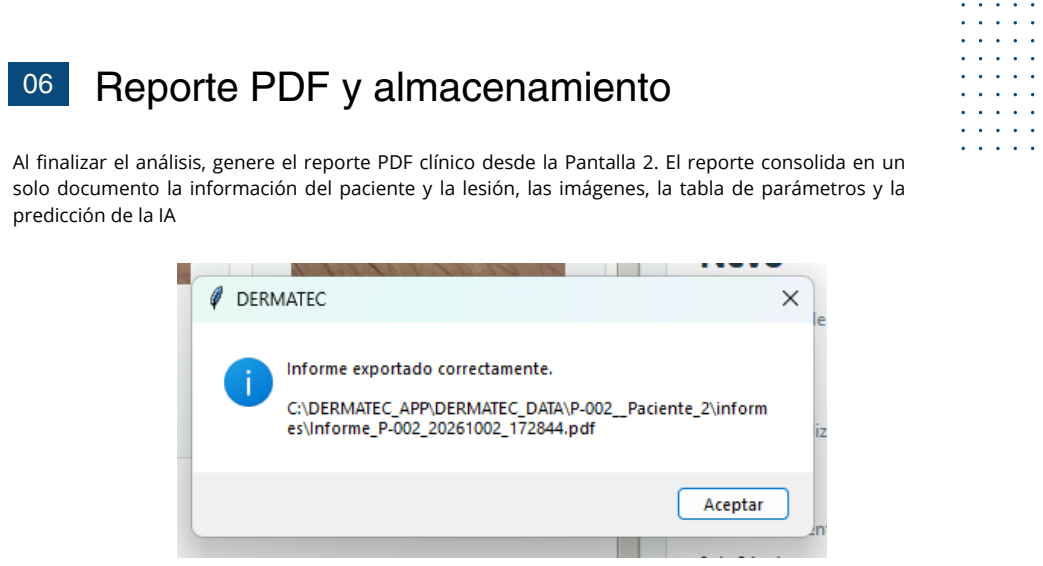
[picture p87: page 20]

Al finalizar el análisis, genere el reporte PDF clínico desde la Pantalla 2. El reporte consolida en un
solo documento la información del paciente y la lesión, las imágenes, la tabla de parámetros y la
predicción de la IA

4

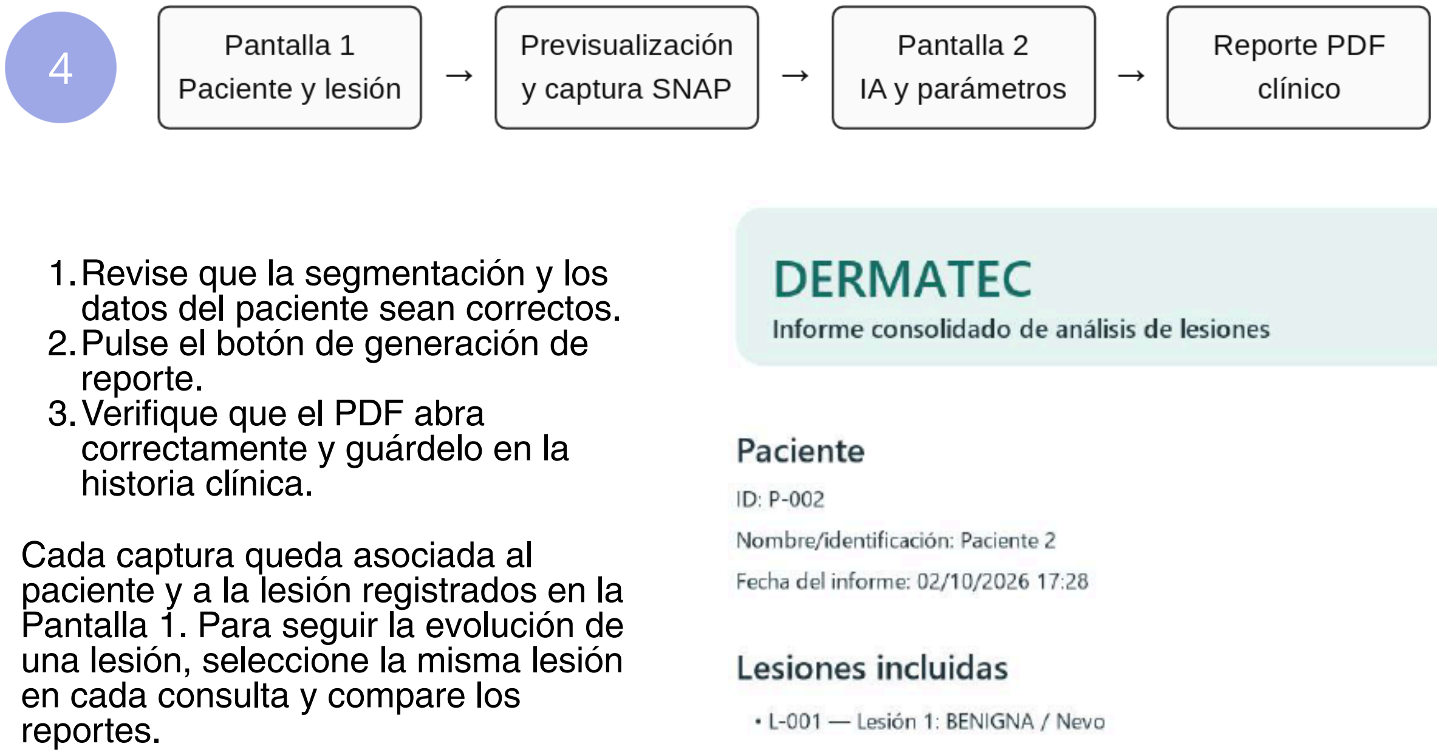
[picture p88: page 21]

1.Revise que la segmentación y los datos del paciente sean correctos. 2.Pulse el botón de generación de reporte.
3.Verifique que el PDF abra correctamente y guárdelo en la historia clínica.
Cada captura queda asociada al paciente y a la lesión registrados en la Pantalla 1. Para seguir la evolución de una lesión, seleccione la misma lesión en cada consulta y compare los reportes.

## Recomendaciones para el procesamiento de la imágen

07

Limpie el acople y los filtros con alcohol isopropílico entre pacientes. Use siempre el mismo aumento y modo de iluminación para capturas de seguimiento de una misma lesión.
Tome más de una captura si hay dudas sobre el enfoque o la segmentación.
Retire el vello grueso o abundante de la zona antes de capturar cuando sea posible.
No exponga el acople de PLA a calor excesivo ni lo deje caer; puede deformarse o fisurarse.

## 07 Solución de posibles problemas

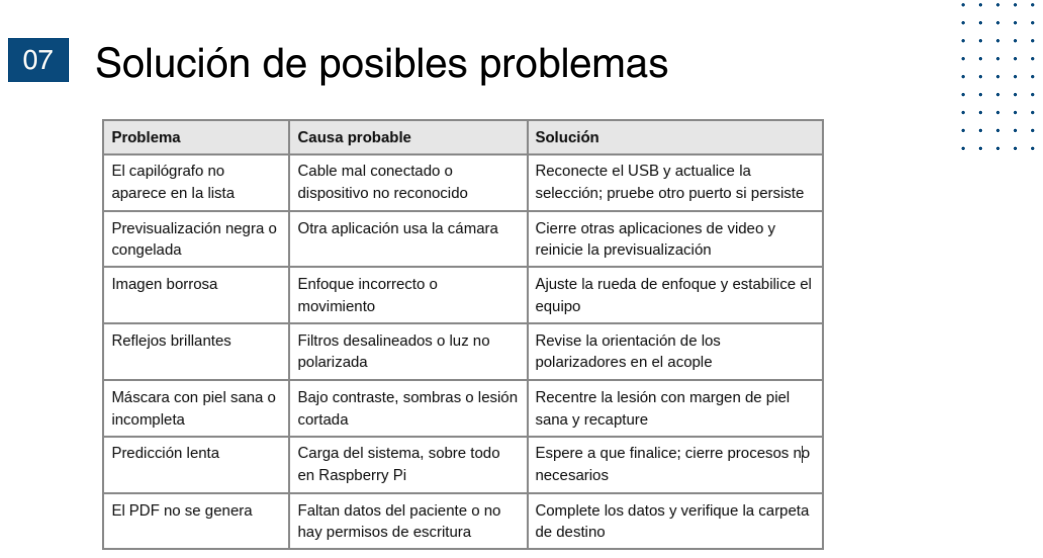
[picture p89: page 23]
