SamanthaTriana/DERMATEC_tg/02_preprocesamiento/Calibracion/CARTA_CALIBRACION_DERMATEC.pdf

## DERMATEC — Carta de calibración (grises + escala en mm)

IMPRIMIR A 'TAMAÑO REAL' / 100 % (NO 'ajustar a la página'), papel blanco mate, calidad alta.
Verifique con una regla que la barra de 50 mm mida exactamente 50 mm. Si no, la escala no sirve (sí los grises). Con el acople de 8 cm la cámara ve ~14 x 10 mm: tome UNA foto por cuadro, con el cuadro llenando toda la imagen. Perilla de luz fija (marcada con cinta) durante todas las fotos.

### 1) ESCALA DE GRISES (11 pasos, valor sRGB indicado debajo)

G1 (255,255,255) | G2 (230,230,230) | G3 (204,204,204) | G4 (179,179,179) | G5 (153,153,153) | G6 (128,128,128)
G7 (102,102,102) | G8 (77,77,77) | G9 (51,51,51) | G10 (26,26,26) | G11 (0,0,0)

### 2) ESCALA PARA CALIBRAR px/mm (50 mm, rayas cada 1 mm)

0 | 10 | 20 | 30 | 40 | 50

En la app: clic en dos rayas largas separadas 10 mm → escribir 10.

### 3) COLORES (solo para comparar antes/después; no se usan para calibrar)

Rojo | Verde | Azul | Cian | Magenta | Amarillo

### 4) REGISTRO

Acople usado: ________ mm Posición perilla de luz: ________ Fecha: ____________ Fotos: G1 ___ G3 ___ G5 ___ G6 ___ G8 ___ G11 ___ (anote el nombre de archivo de cada una)

Los grises impresos se usan para balance de blancos/grises (R=G=B). Para colorimetría completa se requiere una carta con valores medidos (p. ej. ColorChecker 24).
