SamanthaTriana/DERMATEC_tg/03_modelos/Candidato_final/METRICAS_Z18_Z19_ensamble_train_val_test.csv

modelo | conjunto | n | accuracy | macro_f1 | balanced_acc | bin_accuracy | bin_f1 | bin_sens | bin_espec | bin_auc | F1_Nevo | F1_Melanoma | F1_BCC | F1_SCC | Sens_Nevo | Sens_Melanoma | Sens_BCC | Sens_SCC
Z.18 | Train | 12994 | 0.9963059873787902 | 0.9961413152069403 | 0.9970260058094866 | 0.9970755733415423 | 0.9975468043899289 | 0.997933350555412 | 0.9958111195734958 | 0.9999657042239805 | 0.9963802629072204 | 0.9944965045366652 | 0.9982316534040672 | 0.9954568399798082 | 0.9958111195734958 | 0.9952366775826139 | 0.9970562260818369 | 1.0
Z.18 | Validation | 2156 | 0.8794063079777366 | 0.8496020258209085 | 0.8554164313641665 | 0.9308905380333952 | 0.9425818882466281 | 0.9502719502719502 | 0.9021864211737629 | 0.9588135940264825 | 0.9132207338380897 | 0.8563922942206655 | 0.895067264573991 | 0.7337278106508875 | 0.9021864211737629 | 0.8563922942206655 | 0.9023508137432188 | 0.7607361963190185
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
